TijsBeertenStudent/haptic-heartsim/hardware/Bill Of Materials/README.md

# Bill of Materials

This directory contains the Bill of Materials (BOM) for the HeartSim prototype. All purchased and workshop-sourced components are listed in the accompanying spreadsheet:

**[`bill_of_materials.xlsx`](bill_of_materials.xlsx)**

The spreadsheet uses a KU Leuven–themed layout and covers 27 line items across 8 categories. Each row includes the component name, manufacturer and part number, quantity, unit price, total price, supplier, purchase link, datasheet link, and any relevant notes.

---

## Summary

| Category | Line Items | Total Price (€) |
| --- | ---: | ---: |
| Microcontroller | 1 | 21.07 |
| Haptic Drivers  | 3 | 50.43 |
| Audio | 2 | 20.05 |
| Sensors | 1 | 17.46 |
| Power | 1 | 5.19 |
| Mechanical | 4 | 28.95 |
| Wiring | 6 | 34.02 |
| Misc | 9 | 64.00 |
| **Total** | **27** | **241.17** |

*Prices in euros (€), inclusive of VAT where applicable. Shipping costs are not included.*

---

## Notes

- Prices marked "price indicative" (DRV2605L driver ICs, TCA9548A multiplexer, breadboard, jumper cables) were sourced from the KU Leuven workshop stock; exact retail prices may differ.
- The four 3D-printed parts (items 10–12) were produced at FabLab Leuven on a Prusa MK4 printer. The combined FabLab charge of €14.00 has been allocated proportionally across the three print jobs based on estimated filament use.
- For component selection rationale and electrical specifications, see [HeartSim-Report/02_methodology/README.md](../../HeartSim-Report/02_methodology/README.md).
