TijsBeertenStudent/haptic-heartsim/hardware/Bill Of Materials/bill_of_materials.xlsx

ID | Category | Component | Manufacturer / Part No. | Image | Quantity | Unit Price (€) | Total Price (€) | Supplier | Link | Datasheet | Notes
MICROCONTROLLER
1 | Microcontroller | Arduino Nano ESP32 with Headers | Arduino / ABX00083 | #VALUE! | 1 | 21.07 | 21.07 | RS Components | https://benl.rs-online.com/web/p/arduino/2686962 | https://docs.arduino.cc/resources/datasheets/ABX00083-datasheet.pdf | Incl. 21 % VAT
HAPTIC DRIVERS
2 | Haptic drivers | DRV2605L Haptic Driver IC | Texas Instruments / DRV2605L | #VALUE! | 4 | 6.00 | 24.00 | KU Leuven |  | https://www.ti.com/lit/ds/symlink/drv2605l.pdf | KU Leuven workshop; price indicative; 4 needed
3 | Haptic drivers | TCA9548A I2C Multiplexer | Texas Instruments / TCA9548A | #VALUE! | 1 | 10.00 | 10.00 | KU Leuven |  | https://www.ti.com/lit/ds/symlink/tca9548a.pdf | KU Leuven workshop; price indicative
4 | Haptic drivers | Coin Vibration Motor, 3 V, 10 × 2.7 mm | Generic / B09FY7FP16 | #VALUE! | 50 | 0.33 | 16.43 | Amazon.be | https://www.amazon.com.be/dp/B09FY7FP16 |  | 12 used in prototype (3 per module × 4 modules)
AUDIO
5 | Audio | MAX98357A I2S Class D Amplifier Module | Maxim Integrated / MAX98357A | #VALUE! | 2 | 4.30 | 8.59 | Amazon.be | https://www.amazon.com.be/dp/B08SM2MR9Z | https://www.analog.com/media/en/technical-documentation/data-sheets/MAX98357A-MAX98357B.pdf
6 | Audio | Speaker, 40 mm, 2 W, 8 Ω, JST-PH connector | Generic / B0DGQGBP13 | #VALUE! | 4 | 2.87 | 11.46 | Amazon.be | https://www.amazon.com.be/dp/B0DGQGBP13 |  | 100 mm cable; 1 per module
SENSORS
7 | Sensors | DFRobot SEN0203 PPG Sensor | DFRobot / SEN0203 | #VALUE! | 1 | 17.46 | 17.46 | RS Components | https://befr.rs-online.com/web/p/sensor-development-tools/2018097 | https://wiki.dfrobot.com/Heart_Rate_Monitor_Sensor_SKU__SEN0203 | Incl. 21 % VAT
POWER
8 | Power | MB102 Breadboard Power Supply, 3.3 V / 5 V | Joy-it / B-POW | #VALUE! | 1 | 5.19 | 5.19 | Conrad.be | https://www.conrad.be/nl/p/joy-it-b-pow-developmentboard-1-stuk-s-1527413.html |  | €4.29 excl. VAT; incl. 21 % VAT ≈ €5.19
MECHANICAL
9 | Mechanical | Chest Harness, Essentiel-B | Krefel / B8010400 | #VALUE! | 1 | 14.95 | 14.95 | Krefel.be | https://www.krefel.be/nl/p/B8010400-borstharnas |  | Camera mount used as module rail
10 | Mechanical | 3D Print: Haptic Output Module, PLA Black | FabLab Leuven | #VALUE! | 4 | 2.33 | 9.33 | FabLab Leuven |  |  | Prusa MK4; part of €14 FabLab total
11 | Mechanical | 3D Print: Haptic Arduino Base, PLA Black | FabLab Leuven | #VALUE! | 1 | 2.34 | 2.34 | FabLab Leuven |  |  | Prusa MK4; part of €14 FabLab total
12 | Mechanical | 3D Print: Arduino Base Connector, PLA Black | FabLab Leuven | #VALUE! | 1 | 2.33 | 2.33 | FabLab Leuven |  |  | Prusa MK4; part of €14 FabLab total
WIRING
13 | Wiring | PCB Breadboard, 400 points | MMOBIEL / B0CPJNFYDL | #VALUE! | 3 | 2.76 | 8.29 | Amazon.be | https://www.amazon.com.be/dp/B0CPJNFYDL |  | Set of 3
14 | Wiring | Breadboard, 16.4 × 5.5 cm | Generic | #VALUE! | 1 | 2.00 | 2.00 | KU Leuven |  |  | KU Leuven workshop; price indicative
15 | Wiring | Flat Ribbon Cable, 10-pin, 1.27 mm pitch, 6 m | QWORK / B09R42ZGQD | #VALUE! | 1 | 7.45 | 7.45 | Amazon.be | https://www.amazon.com.be/dp/B09R42ZGQD |  | For 2.54 mm connectors
16 | Wiring | JST-XH Connector Set, 460 pcs, 2–6 pin | YIXISI / B082ZLYRRN | #VALUE! | 1 | 8.99 | 8.99 | Amazon.be | https://www.amazon.com.be/dp/B082ZLYRRN |  | 2.54 mm female + pin terminals
17 | Wiring | Jumper Cables, Arduino kit | Generic |  | 1 | 5.00 | 5.00 | KU Leuven |  |  | KU Leuven workshop; price indicative
18 | Wiring | USB Data Cable, Micro-USB, 3 m | Sologic / 3202971 | #VALUE! | 1 | 2.29 | 2.29 | Action | https://www.action.com/nl-be/p/3202971/sologic-laad-en-datakabel-micro-usb/ |  | For firmware upload and power
TOOLS
19 | Tools | Velcro Tape, Self-Adhesive, 60 cm × 20 mm, Black | Fix-O-Moll / B610895 | #VALUE! | 1 | 4.09 | 4.09 | Gamma | https://www.gamma.be/nl/assortiment/fix-o-moll-klittenband-zelfklevend-60-cm-x-20-mm-zwart/p/B610895 |  | Module mounting on harness
20 |  | Super Glue, 20 ml | Handson / B210535 | #VALUE! | 1 | 4.99 | 4.99 | Gamma | https://www.gamma.be/nl/assortiment/handson-secondelijm-20-ml/p/B210535
21 | Tools | Heat Shrink Tubing, 1–3 mm, Black, 5 pcs | Profile / B317434 | #VALUE! | 1 | 4.19 | 4.19 | Gamma | https://www.gamma.be/nl/assortiment/profile-krimpkous-1-3-mm-zwart-5-st/p/B317434
22 |  | Heat Shrink Tubing, Black, 6 pcs | Profile / 122337 | #VALUE! | 1 | 7.78 | 7.78 | Hubo | https://www.hubo.be/nl/p/profile-krimpkous-zwart-6-stuks/122337/
23 | Tools | Insulation Tape, 15 mm × 10 m, 5 pcs | Generic / 3014580 | #VALUE! | 1 | 0.99 | 0.99 | Action | https://www.action.com/nl-be/p/3014580/isolatietape/
24 |  | Hot Glue Sticks, Ø 11 mm × 280 mm, Black | Parkside / 100380799 | #VALUE! | 1 | 4.99 | 4.99 | Lidl | https://www.lidl.be/p/nl-BE/lijmstiften-o-11-mm-l-280-mm-parkside/p100380799
25 | Tools | Hot Glue Gun | Parkside / 100397989 | #VALUE! | 1 | 4.49 | 4.49 | Lidl | https://www.lidl.be/p/nl-BE/parkside-hetelijmpistool/p100397989 |  | Assembly tool
26 |  | Crimping Pliers Set | Parkside | #VALUE! | 1 | 19.99 | 19.99 | Lidl | https://www.lidl.be/ |  | Assembly tool; connector crimping
27 | Tools | Cable Lug Connector Set with Pliers | Handson / B627659 | #VALUE! | 1 | 12.49 | 12.49 | Gamma | https://www.gamma.be/nl/assortiment/handson-kabelschoenset-met-tang/p/B627659 |  | Includes tool + consumable cable lugs
28 | Tools | Soldering iron, Solder, Scissors, Pliers, Knife,Computer, ... | / | / | / | / | / | / | / | / | Various basic products/ tools were needed wich we already had or were able to borrow
MEDICAL
29 | Medical | Littmann Master Cardiology-stethoscoop | Littmann | #VALUE! | 1 | 305.00 | 305.00 | Already owned | https://deforcemedical.be/nl/catalogus/diagnose/littmann-master-cardiology-stethoscoop-zwart |  | The stethoscope we used is a Littmann Cardiology IV™ diagnostic stethoscope, a specialised model with superior acoustic performance for detecting very subtle body sounds, especially in cardiology. It is more expensive than a standard stethoscope because it provides better sound quality, improved noise reduction, and higher build quality for professional use. A normal stethoscope is available from about €100, while advanced models like this cost more due to their precision and durability.
Total Cost
 |  |  |  |  |  | TOTAL | 546.17
 |  |  |  |  |  | TOTAL without stethoscope | 241.17
 |  |  |  |  |  | TOTAL SPEND | 200.17 |  | The estimated cost of our project is higher because we already had a stethoscope, which is an expensive component. Although it is necessary for testing and experimentation, it is not part of the core concept itself. Additionally, we were able to use some equipment from KU Leuven, which meant we did not need to purchase those parts.
 |  |  |  |  |  |  |  |  | Note that all prices include taxes but exclude shipping costs
