TijsBeertenStudent/haptic-heartsim/(list of files, cad)

Other CAD files:
hardware/cad/Haptic HeartSim Output module.prt
hardware/cad/Haptic HeartSim base connector.prt
hardware/cad/Haptic HeartSim base.prt
