TijsBeertenStudent/haptic-heartsim/(commit log)

2026-05-21 Initial commit: full HeartSim documentation and firmware
    Complete repository for the HeartSim wearable haptic cardiac
    auscultation simulator. Includes English documentation (introduction,
    medical background, methodology, discussion, future work, references),
    Arduino Nano ESP32 firmware with procedural heart sound synthesis,
    hardware schematics, BOM, CAD files, and web interface.
    [Haptic HeartSim Output module.prt, Haptic HeartSim base connector.prt, Haptic HeartSim base.prt, bill_of_materials.xlsx]
2026-05-21 Restructure: remove empty README, flatten software folder, remove unused image
    - Remove empty top-level README.md (CONTEXT.md serves as entry point)
    - Move software/heartsim_ok/* to software/* (flatten one level)
    - Remove docs/00_introduction/images/module_placement_diagram.png
    - Update CONTEXT.md and introduction references accordingly
    - Fix .gitignore paths for new software layout
    [audio_engine.cpp, audio_engine.h, config.h, cycle_engine.cpp, cycle_engine.h, haptic_manager.cpp, haptic_manager.h]
2026-05-21 Rename hardware/bom to hardware/Bill Of Materials
    [bill_of_materials.xlsx]
2026-05-21 HeartSim — final repository layout
